trungnguyen1408/Automatic-Light/README.md

# Automatic-Light

- Thiết bị điều khiển đèn tự động **Automatic Light** điều khiển đèn dựa vào *số người có trong phòng*
- Người đầu tiên vào phòng, đèn sẽ tự động sáng. Thiết bị sẽ đếm số người ra/vào phòng và hiện thị trên LCD.
- Khi người **cuối cùng** ra khỏi phòng đèn sẽ tựu động tắt sau 1 phút.
