trungnguyen1408/Automatic-Light/(list of files, cad)

Other CAD files:
Code/main.OBJ
