trungnguyen1408/Automatic-Light/SCHEMATIC.pdf

TR101

D101

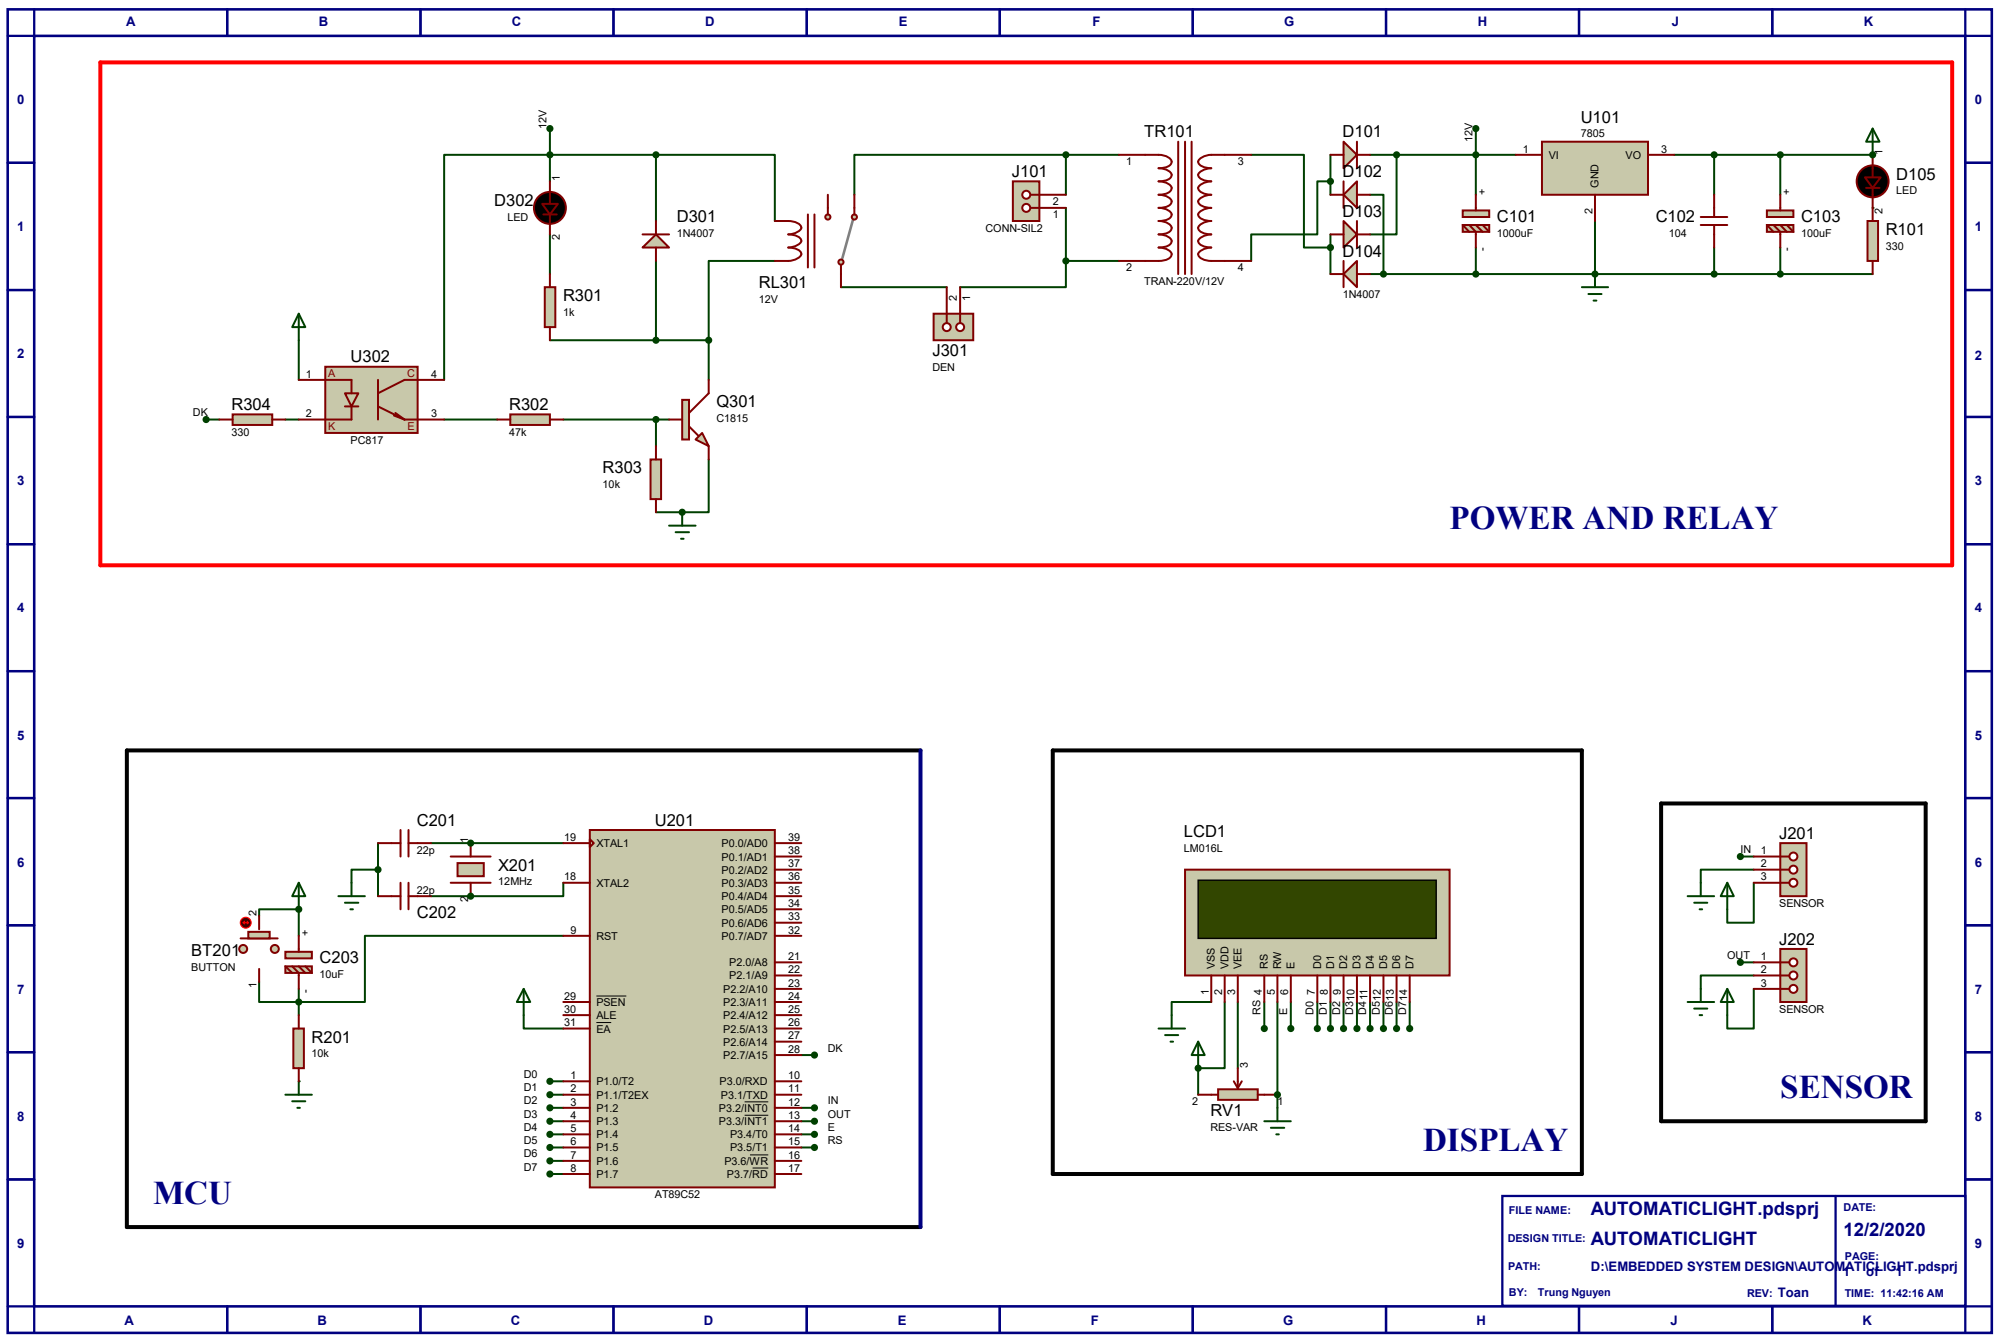
[picture p26: page 1]
