trungnguyen1408/Automatic-Light/(list of files, drawings)

Other design files:
Schematic and Layout/AUTOMATICLIGHT.pdsprj
